Asongnabrilan-nso/julia-x1/mechanical/Julia-X Joy/Julia-X1 Joy-lid.3mf

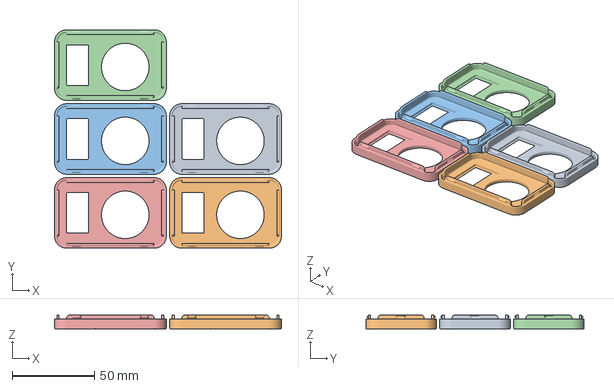
[picture p1: CAD file, 2026-10-12]
mechanical/Julia-X Joy/Julia-X1 Joy-lid.3mf
137.6 x 132.4 x 8.60 mm
Julia-X1 Joy-lid x 5
