Asongnabrilan-nso/julia-x1/mechanical/Julia-X1-logo.3mf

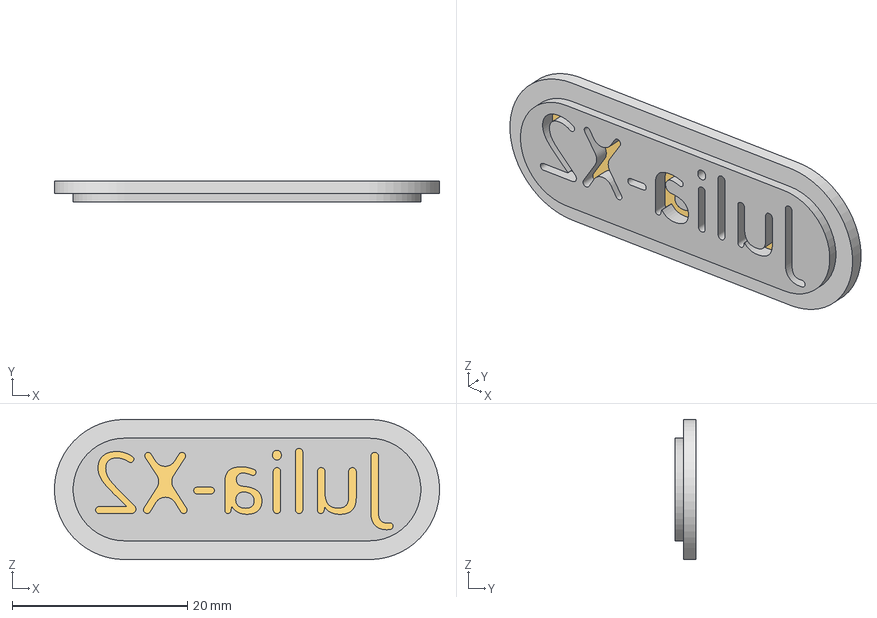
[picture p2: CAD file, 2026-10-12]
mechanical/Julia-X1-logo.3mf
44.0 x 2.40 x 16.0 mm
Julia-X2 logo (1)
Julia-X2 logo
