Asongnabrilan-nso/julia-x1/mechanical/Julia-X Joy/Julia-X1 Joy-v2-base.3mf

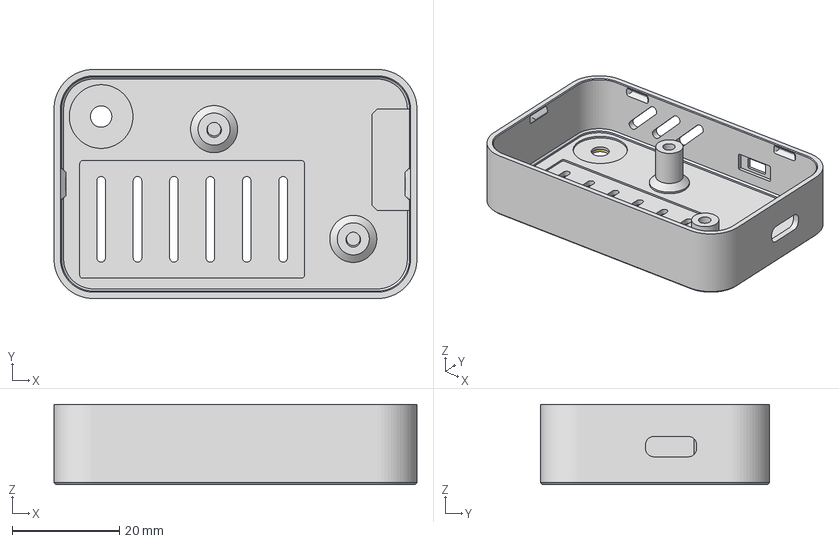
[picture p3: CAD file, 2026-10-12]
mechanical/Julia-X Joy/Julia-X1 Joy-v2-base.3mf
67.8 x 42.8 x 15.0 mm
joy bottom body
