Asongnabrilan-nso/julia-x1/mechanical/top-frame2.3mf

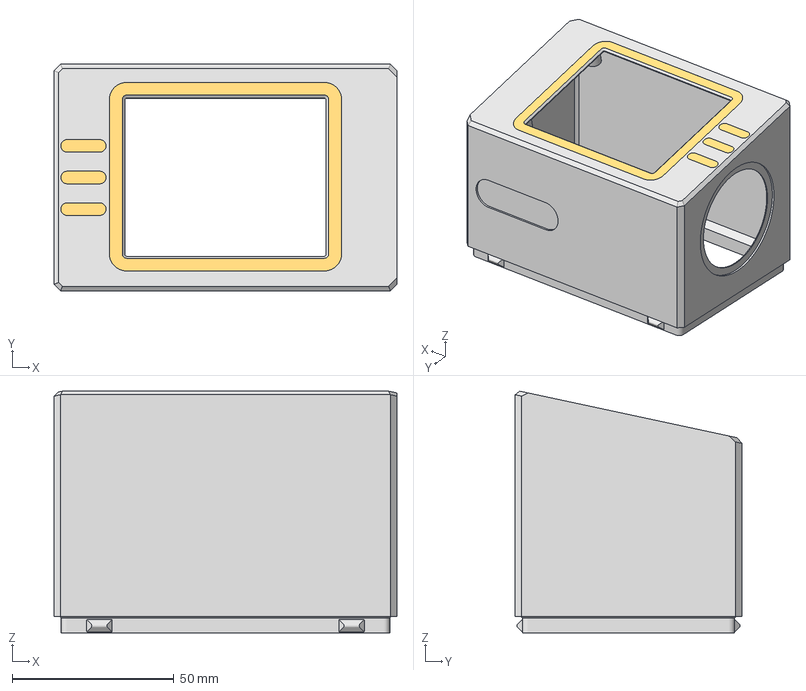
[picture p4: CAD file, 2026-10-12]
mechanical/top-frame2.3mf
106.0 x 70.0 x 74.7 mm
top frame2
