Asongnabrilan-nso/julia-x1/mechanical/top frame2-test.3mf

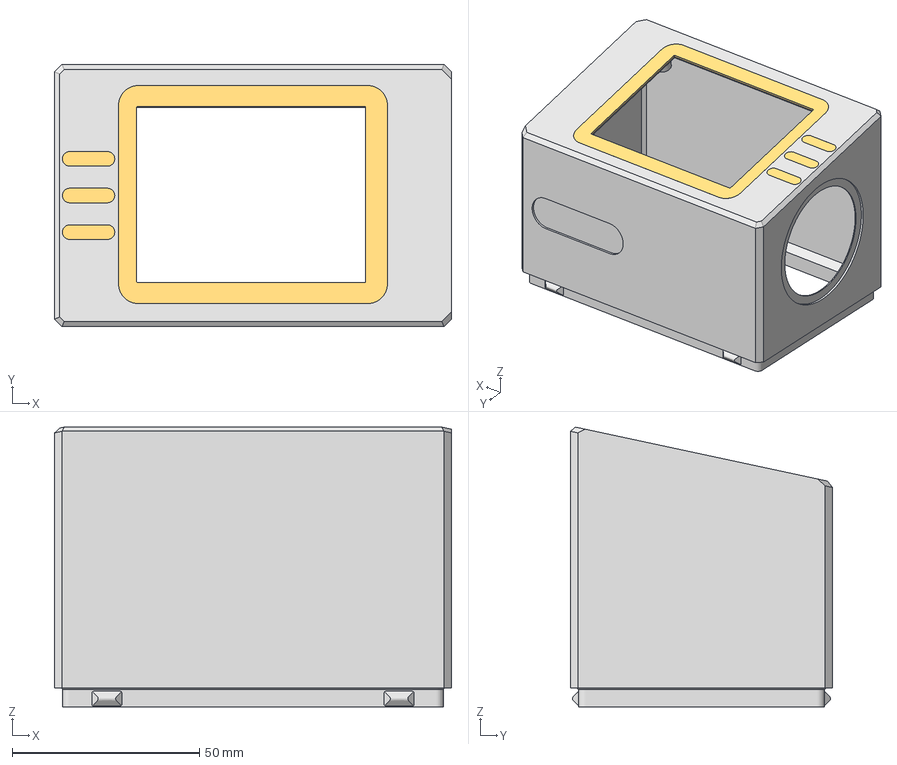
[picture p5: CAD file, 2026-10-12]
mechanical/top frame2-test.3mf
106.0 x 70.0 x 74.7 mm
top frame2
