Asongnabrilan-nso/julia-x1/mechanical/Uno Q support carrier.stl

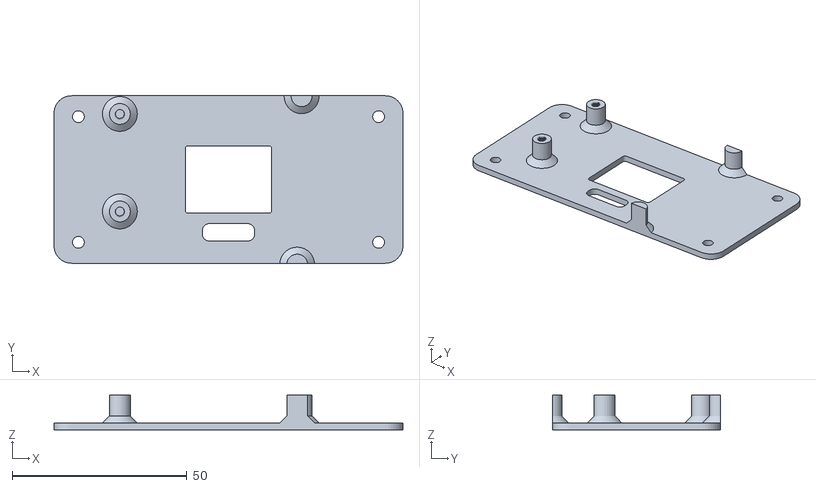
[picture p6: CAD file, 2026-10-12]
mechanical/Uno Q support carrier.stl
100.0 x 48.0 x 10.0
