Asongnabrilan-nso/julia-x1/mechanical/Julia-X1-side-ring.3mf

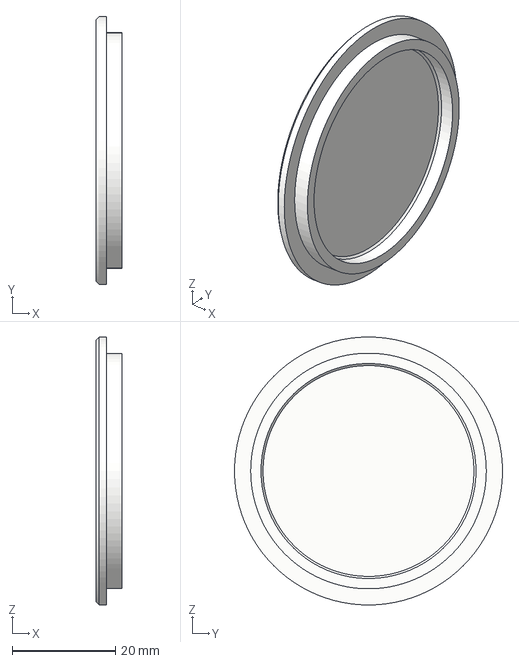
[picture p7: CAD file, 2026-10-12]
mechanical/Julia-X1-side-ring.3mf
5.00 x 52.0 x 52.0 mm
