Asongnabrilan-nso/julia-x1/mechanical/5mm support.stl

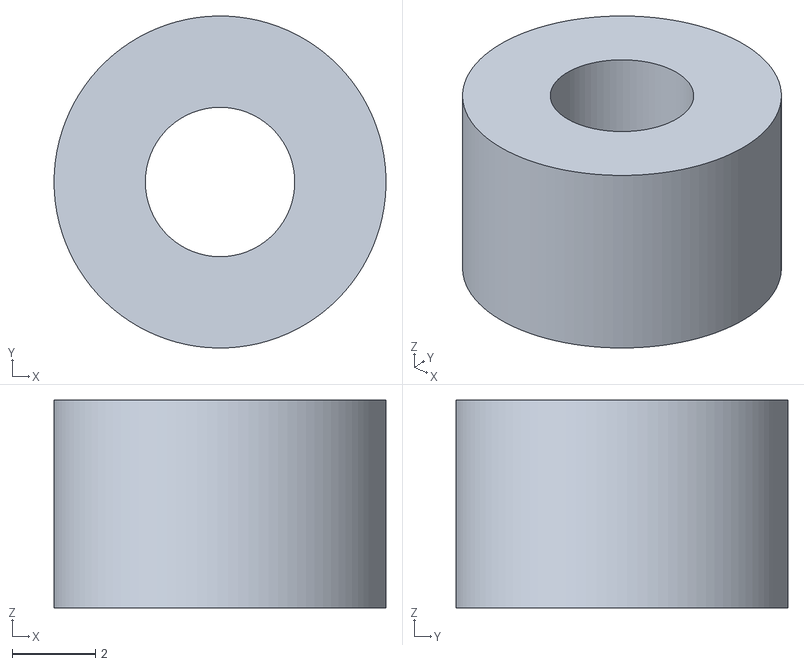
[picture p8: CAD file, 2026-10-12]
mechanical/5mm support.stl
8.00 x 8.00 x 5.00
