Asongnabrilan-nso/julia-x1/mechanical/45mm support.stl

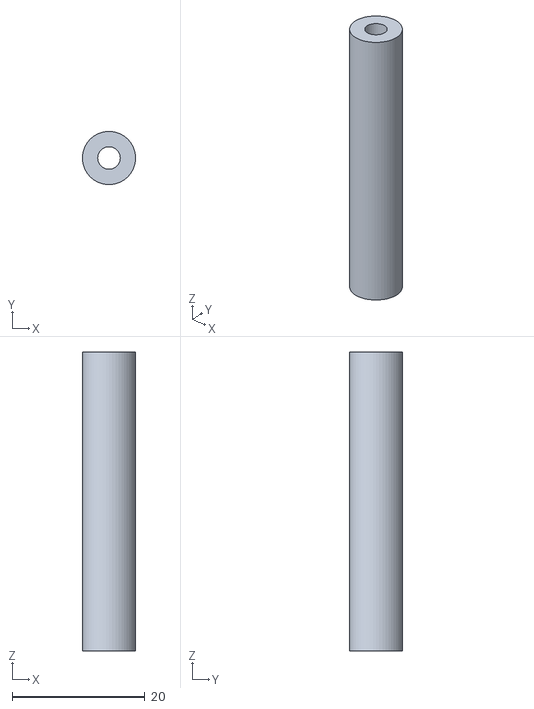
[picture p9: CAD file, 2026-10-12]
mechanical/45mm support.stl
8.00 x 8.00 x 45.0
