Asongnabrilan-nso/julia-x1/(list of files, cad)

Other CAD files:
mechanical/top frame.3mf
mechanical/top frame2-test.stl
